Nithish-SA/Logic-Analyzer/README.md

# Logic-Analyzer
A 16 channel at 100Mhz Logic Analyzer which is supported by Cypress FX3 (USB 3.0 MCU).
