Nithish-SA/Logic-Analyzer/LA-V2.0.kicad_pcb

## KiCad design LA-V2.0.kicad_pcb (2025-07-25)

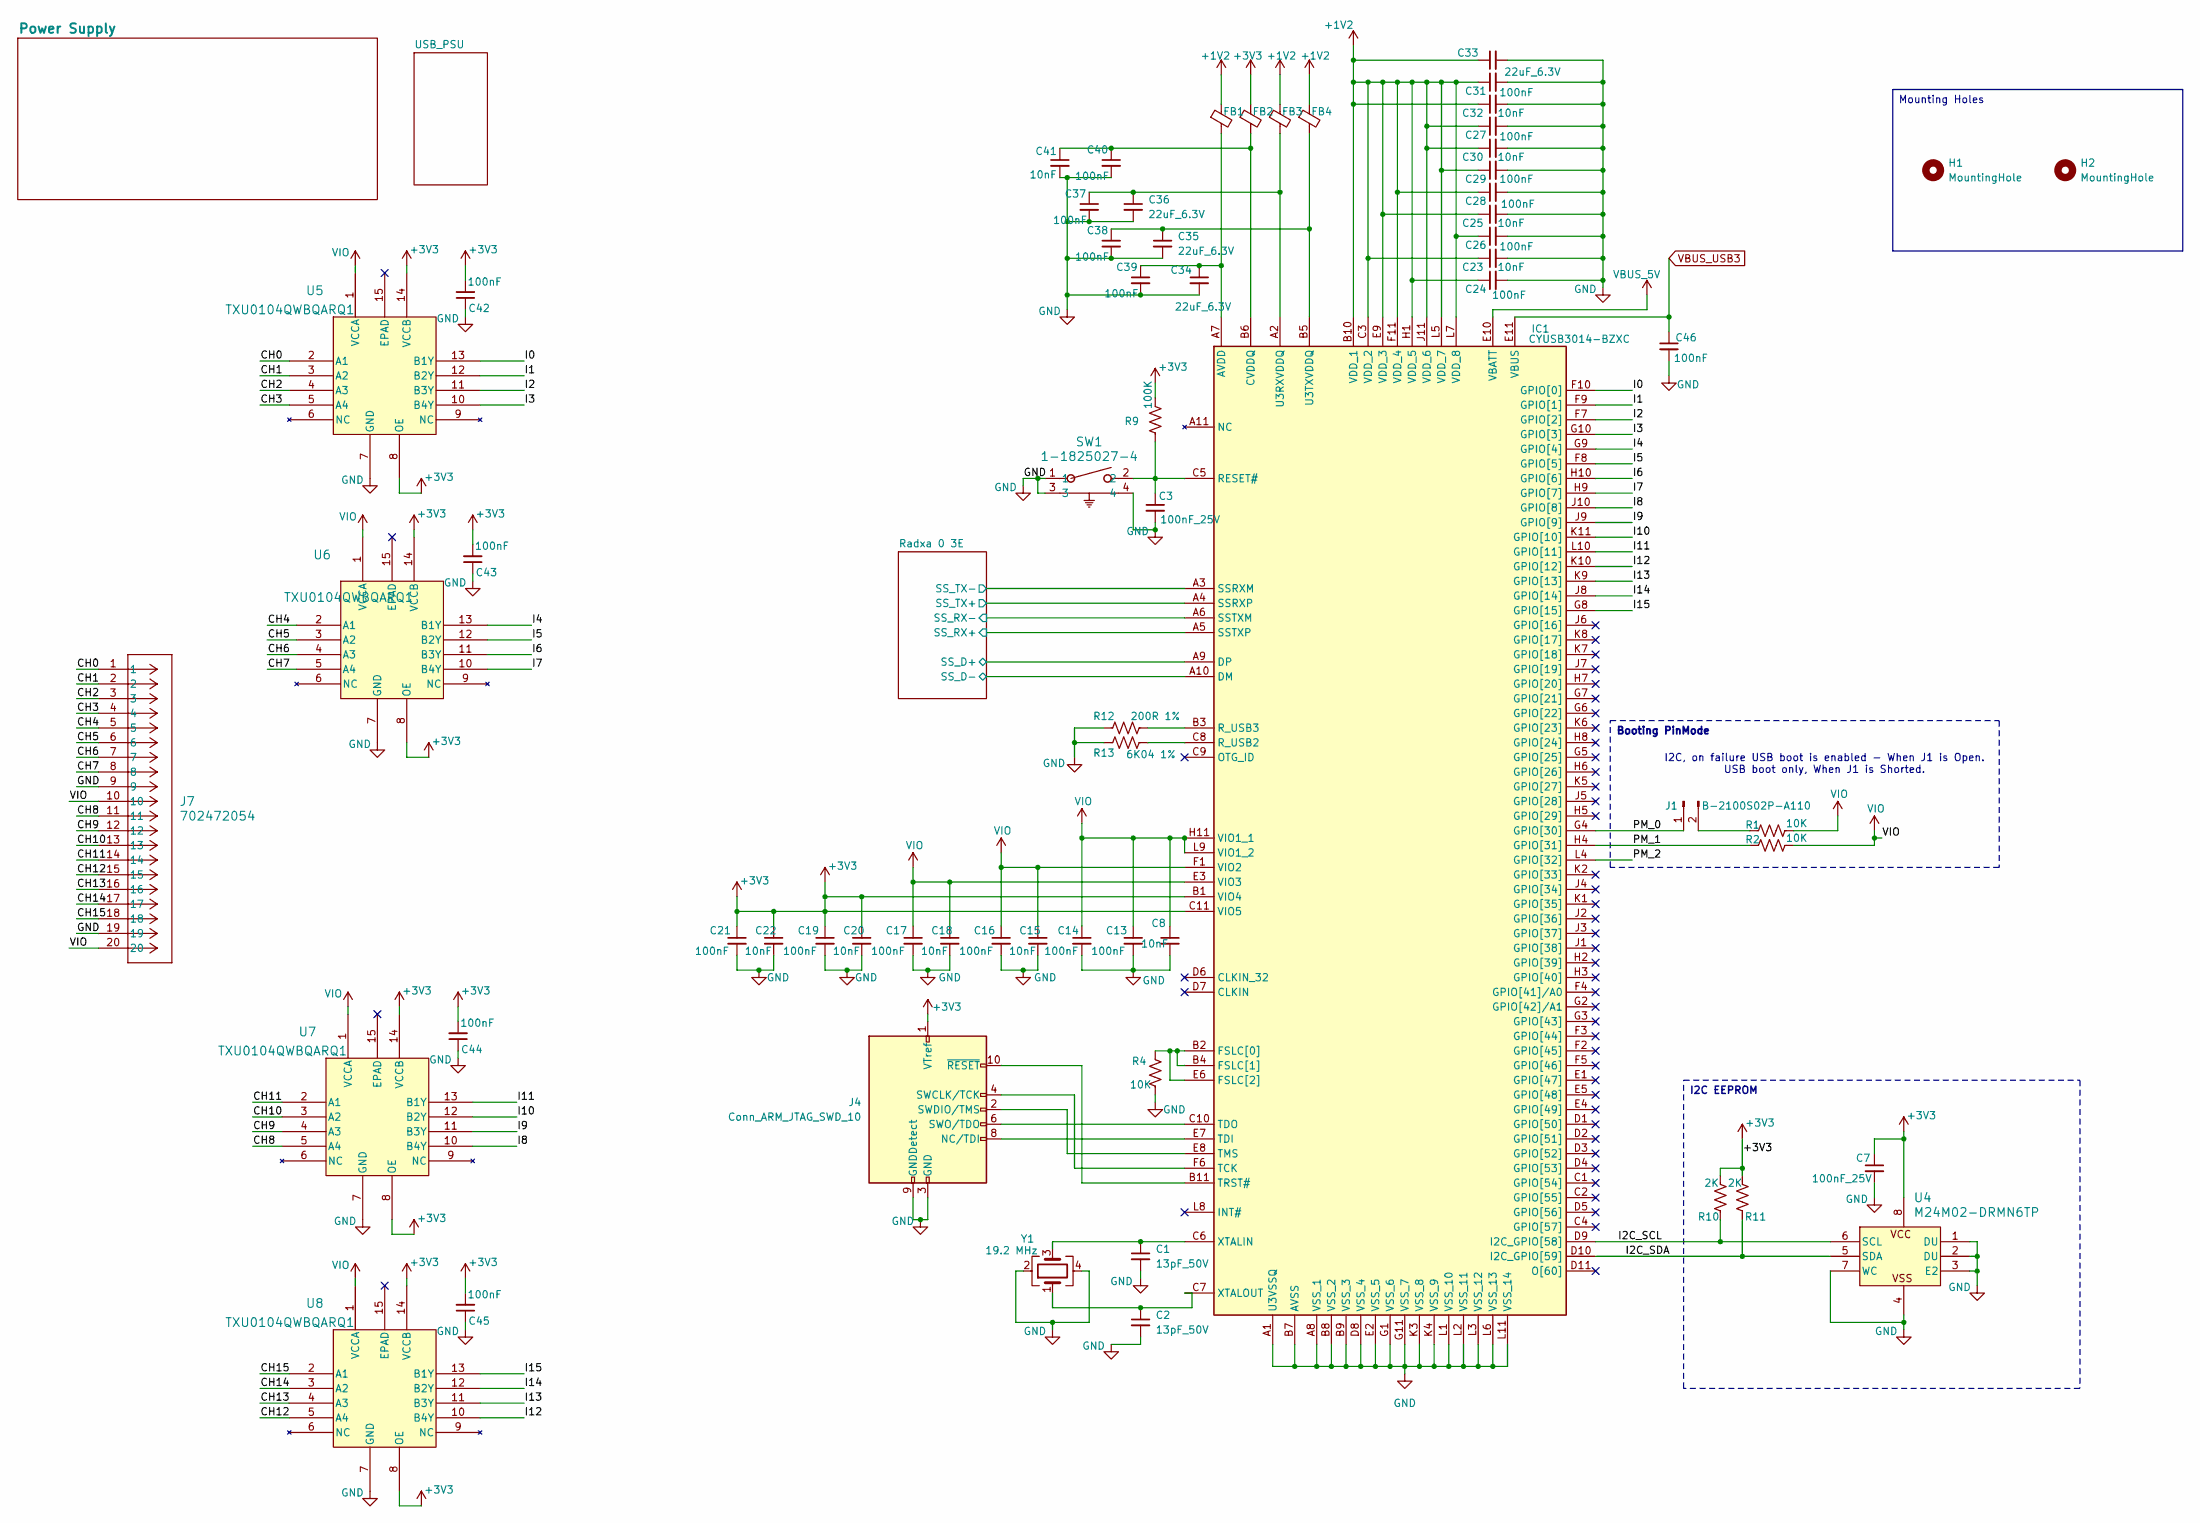
[picture p1: schematic LA-V2.0.kicad_sch]

Parts:
C1, C2: 13pF_50V; C_0402_1005Metric; LCSC Part# C161306
C3, C7: 100nF_25V; C_0402_1005Metric; LCSC Part# C155422
C8, C15, C18, C20, C22, C23, C25, C30, C32, C41: 10nF; C_0402_1005Metric; LCSC Part# C60133
C13, C14, C16, C17, C19, C21, C24, C26, C27, C28, C29, C31, C37, C38, C39, C40, C42, C43, C44, C45, C46: 100nF; C_0402_1005Metric; LCSC Part# C155422
C33: 22uF_6.3V; C_0805_2012Metric; LCSC Part# C5674
C34, C35, C36: 22uF_6.3V; C_0402_1005Metric; LCSC Part# C415703
FB1, FB2, FB3, FB4: FerriteBead_Small; L_0805_2012Metric; LCSC Part# C81034
H1, H2: MountingHole; MountingHole_2.7mm_M2.5_ISO14580_Pad_TopOnly
IC1: CYUSB3014-BZXC; Manufacturer_Part_Number CYUSB3014-BZXC; LCSC Part# C462526
J1: B-2100S02P-A110; PinHeader_1x02_P2.54mm_Vertical; LCSC Part# C124375
J4: Conn_ARM_JTAG_SWD_10; PinHeader_2x05_P2.54mm_Vertical; LCSC Part# C492422
J7: 702472054; CONN_7024720xx_MOL; LCSC Part# C17505050
R1, R2, R4: 10K; R_0402_1005Metric; LCSC Part# C60490
R9: 100K; R_0805_2012Metric; LCSC Part# C122537
R10, R11: 2K; R_0805_2012Metric; LCSC Part# C114572
R12: 200R 1%; R_0402_1005Metric; LCSC Part# C114764
R13: 6K04 1%; R_0805_2012Metric; LCSC Part# C3014413
SW1: 1-1825027-4; SW2_1825027-E_TEC; LCSC Part# C2928195
U4: M24M02-DRMN6TP; SO_RMN6TP_STM; LCSC Part# C115042
U5, U6, U7, U8: TXU0104QWBQARQ1; WQFN14_BQA_TEX; LCSC Part# C5217874
Y1: 19.2 MHz; Crystal_SMD_3225-4Pin_3.2x2.5mm; LCSC Part# C7294560

Connections:
+1V2: C23.1, C24.1, C25.1, C26.1, C27.1, C28.1, C29.1, C30.1, C31.1, C32.1, C33.1, FB1.1, FB3.1, FB4.1, IC1.B10 (VDD_1), IC1.C3 (VDD_2), IC1.E9 (VDD_3), IC1.F11 (VDD_4), IC1.H1 (VDD_5), IC1.J11 (VDD_6), IC1.L5 (VDD_7), IC1.L7 (VDD_8); also elsewhere on the board
+3V3: C7.1, C19.1, C20.1, C21.1, C22.1, C42.2, C43.2, C44.2, C45.2, FB2.1, IC1.B1 (VIO4), IC1.C11 (VIO5), J4.1 (VTref), R9.2, R10.2, R11.2, U4.8, U5.8 (OE), U5.14 (VCCB), U6.8 (OE), U6.14 (VCCB), U7.8 (OE), U7.14 (VCCB), U8.8 (OE), U8.14 (VCCB); also elsewhere on the board
/CH0: J7.1, U5.2 (A1)
/CH1: J7.2, U5.3 (A2)
/CH2: J7.3, U5.4 (A3)
/CH3: J7.4, U5.5 (A4)
/CH4: J7.5, U6.2 (A1)
/CH5: J7.6, U6.3 (A2)
/CH6: J7.7, U6.4 (A3)
/CH7: J7.8, U6.5 (A4)
/CH8: J7.11, U7.5 (A4)
/CH9: J7.12, U7.4 (A3)
/CH10: J7.13, U7.3 (A2)
/CH11: J7.14, U7.2 (A1)
/CH12: J7.15, U8.5 (A4)
/CH13: J7.16, U8.4 (A3)
/CH14: J7.17, U8.3 (A2)
/CH15: J7.18, U8.2 (A1)
/I0: IC1.F10 (GPIO[0]), U5.13 (B1Y)
/I1: IC1.F9 (GPIO[1]), U5.12 (B2Y)
/I2: IC1.F7 (GPIO[2]), U5.11 (B3Y)
/I2C_SCL: IC1.D9 (I2C_GPIO[58]), R10.1, U4.6 (SCL)
/I2C_SDA: IC1.D10 (I2C_GPIO[59]), R11.1, U4.5 (SDA)
/I3: IC1.G10 (GPIO[3]), U5.10 (B4Y)
/I4: IC1.G9 (GPIO[4]), U6.13 (B1Y)
/I5: IC1.F8 (GPIO[5]), U6.12 (B2Y)
/I6: IC1.H10 (GPIO[6]), U6.11 (B3Y)
/I7: IC1.H9 (GPIO[7]), U6.10 (B4Y)
/I8: IC1.J10 (GPIO[8]), U7.10 (B4Y)
/I9: IC1.J9 (GPIO[9]), U7.11 (B3Y)
/I10: IC1.K11 (GPIO[10]), U7.12 (B2Y)
/I11: IC1.L10 (GPIO[11]), U7.13 (B1Y)
/I12: IC1.K10 (GPIO[12]), U8.10 (B4Y)
/I13: IC1.K9 (GPIO[13]), U8.11 (B3Y)
/I14: IC1.J8 (GPIO[14]), U8.12 (B2Y)
/I15: IC1.G8 (GPIO[15]), U8.13 (B1Y)
/PM_0: IC1.G4 (GPIO[30]), J1.1
/PM_1: IC1.H4 (GPIO[31]), R2.1
/PM_2: IC1.L4 (GPIO[32])
/Radxa 0 3E/SS_D+: IC1.A9 (DP); also elsewhere on the board
/Radxa 0 3E/SS_D-: IC1.A10 (DM); also elsewhere on the board
/Radxa 0 3E/SS_RX+: IC1.A5 (SSTXP); also elsewhere on the board
/Radxa 0 3E/SS_RX-: IC1.A6 (SSTXM); also elsewhere on the board
/Radxa 0 3E/SS_TX+: IC1.A4 (SSRXP); also elsewhere on the board
/Radxa 0 3E/SS_TX-: IC1.A3 (SSRXM); also elsewhere on the board
GND: C1.2, C2.2, C3.2, C7.2, C8.2, C13.2, C14.2, C15.2, C16.2, C17.2, C18.2, C19.2, C20.2, C21.2, C22.2, C23.2, C24.2, C25.2, C26.2, C27.2, C28.2, C29.2, C30.2, C31.2, C32.2, C33.2, C34.2, C35.2, C36.2, C37.2, C38.2, C39.2, C40.2, C41.2, C42.1, C43.1, C44.1, C45.1, C46.2, IC1.A1 (U3VSSQ), IC1.A8 (VSS_1), IC1.B7 (AVSS), IC1.B8 (VSS_2), IC1.B9 (VSS_3), IC1.D8 (VSS_4), IC1.E2 (VSS_5), IC1.G1 (VSS_6), IC1.G11 (VSS_7), IC1.K3 (VSS_8), IC1.K4 (VSS_9), IC1.L1 (VSS_10), IC1.L2 (VSS_11), IC1.L3 (VSS_12), IC1.L6 (VSS_13), IC1.L11 (VSS_14), J4.3 (GND), J4.5 (GND), J4.9 (GNDDetect), J7.9, J7.19, R4.1, R12.2, R13.2, SW1.1, SW1.3, SW1.4, U4.1 (DU), U4.2 (DU), U4.3 (E2), U4.4, U4.7 (WC), U5.7 (GND), U6.7 (GND), U7.7 (GND), U8.7 (GND), Y1.2, Y1.4; also elsewhere on the board
unnamed: C34.1, C39.1, FB1.2, IC1.A7 (AVDD)
unnamed: C40.1, C41.1, FB2.2, IC1.B6 (CVDDQ)
unnamed: IC1.B2 (FSLC[0]), IC1.B4 (FSLC[1]), IC1.E6 (FSLC[2]), R4.2
unnamed: C3.1, IC1.C5 (RESET#), R9.1, SW1.2
unnamed: IC1.C8 (R_USB2), R13.1
unnamed: IC1.B3 (R_USB3), R12.1
unnamed: IC1.F6 (TCK), J4.4 (SWCLK/TCK)
unnamed: IC1.E7 (TDI), J4.8 (NC/TDI)
unnamed: IC1.C10 (TDO), J4.6 (SWO/TDO)
unnamed: IC1.E8 (TMS), J4.2 (SWDIO/TMS)
unnamed: IC1.B11 (TRST#), J4.10 (~RESET)
unnamed: C36.1, C37.1, FB3.2, IC1.A2 (U3RXVDDQ)
unnamed: C35.1, C38.1, FB4.2, IC1.B5 (U3TXVDDQ)
unnamed: C1.1, IC1.C6 (XTALIN), Y1.3
unnamed: C2.1, IC1.C7 (XTALOUT), Y1.1
unnamed: J1.2, R1.1
VBUS_5V: IC1.E10 (VBATT); also elsewhere on the board
VBUS_USB3: C46.1, IC1.E11 (VBUS); also elsewhere on the board
VIO: C8.1, C13.1, C14.1, C15.1, C16.1, C17.1, C18.1, IC1.E3 (VIO3), IC1.F1 (VIO2), IC1.H11 (VIO1_1), IC1.L9 (VIO1_2), J7.10, J7.20, R1.2, R2.2, U5.1 (VCCA), U6.1 (VCCA), U7.1 (VCCA), U8.1 (VCCA); also elsewhere on the board

Notes on the sheet:
I2C, on failure USB boot is enabled - When J1 is Open. USB boot only, When J1 is Shorted.
Booting PinMode
I2C EEPROM
Mounting Holes

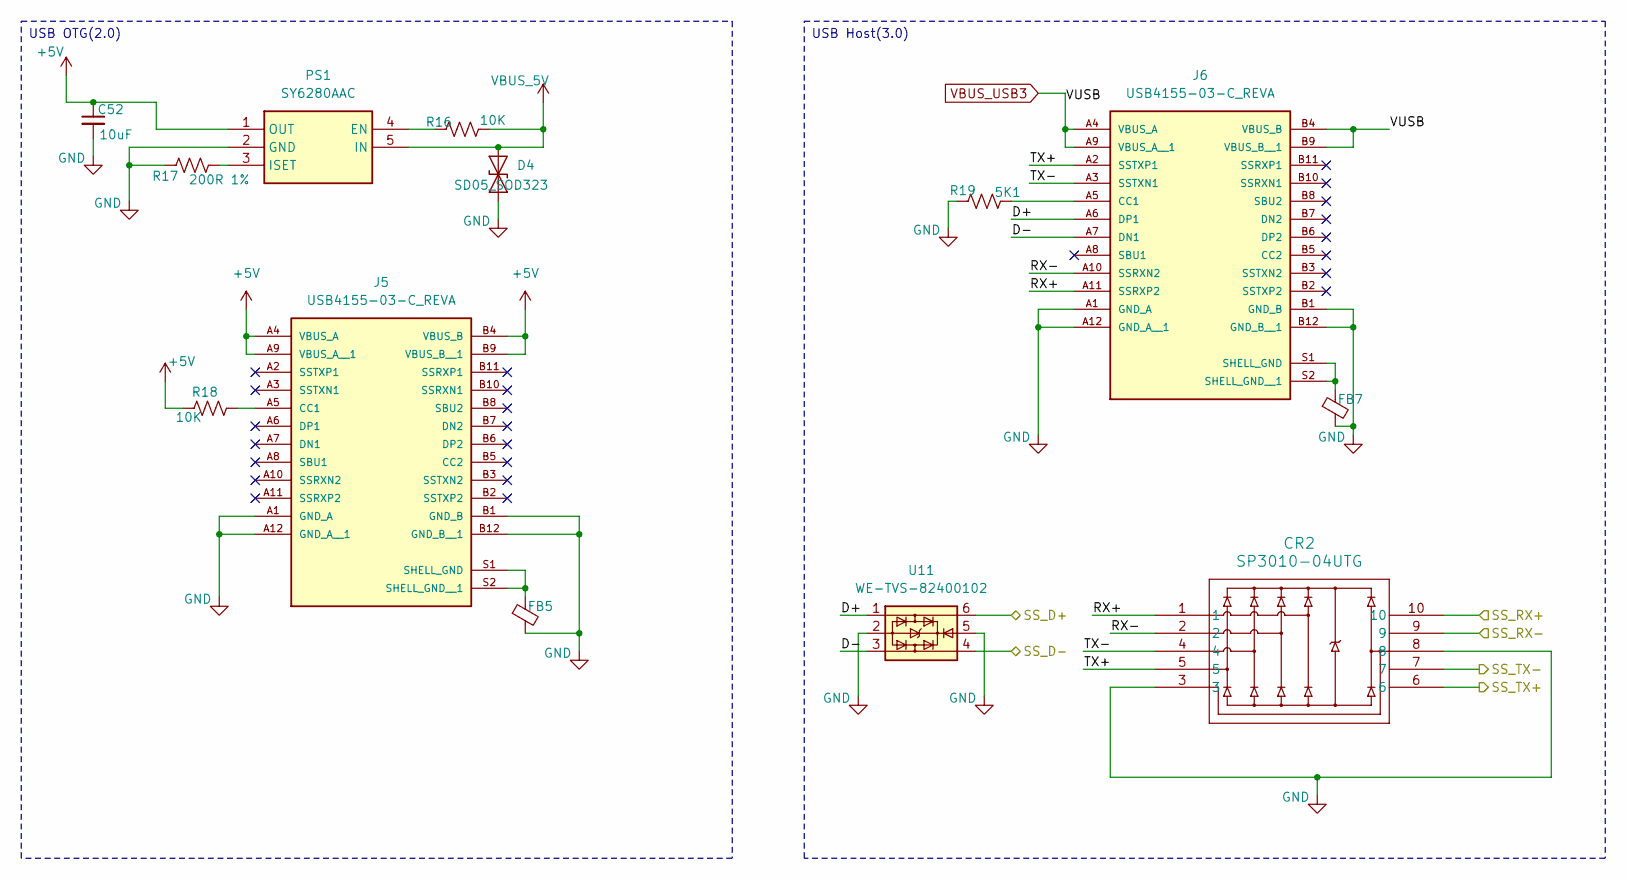
[picture p2: schematic Radxa.kicad_sch]

Parts:
C52: 10uF; C_0402_1005Metric; LCSC Part# C32635
CR2: SP3010-04UTG; UDFEN-10_MO229_LTF-L; LCSC Part# C126837
D4: SD05_SOD323; D_SOD-323
FB5, FB7: FerriteBead_Small; L_0805_2012Metric; LCSC Part# C81034
J5, J6: USB4155-03-C_REVA; USB Plug-GCT_USB4155-03-C_REVA; PARTREV A
PS1: SY6280AAC; SOT95P285X140-5N; Manufacturer_Part_Number SY6280AAC
R16, R18: 10K; R_0402_1005Metric; LCSC Part# C60490
R17: 200R 1%; R_0402_1005Metric; LCSC Part# C114764
R19: 5K1; R_0402_1005Metric; LCSC Part# C351692
U11: WE-TVS-82400102; SOT-23-6; LCSC Part# C22435120

Connections:
+5V: C52.1, J5.A4 (VBUS_A), J5.A9 (VBUS_A__1), J5.B4 (VBUS_B), J5.B9 (VBUS_B__1), PS1.1 (OUT), R18.1
/Radxa 0 3E/D+: J6.A6 (DP1), U11.1
/Radxa 0 3E/D-: J6.A7 (DN1), U11.3
/Radxa 0 3E/RX+: CR2.1, J6.A11 (SSRXP2)
/Radxa 0 3E/RX-: CR2.2, J6.A10 (SSRXN2)
/Radxa 0 3E/SS_D+: U11.6; also elsewhere on the board
/Radxa 0 3E/SS_D-: U11.4; also elsewhere on the board
/Radxa 0 3E/SS_RX+: CR2.10; also elsewhere on the board
/Radxa 0 3E/SS_RX-: CR2.9; also elsewhere on the board
/Radxa 0 3E/SS_TX+: CR2.6; also elsewhere on the board
/Radxa 0 3E/SS_TX-: CR2.7; also elsewhere on the board
/Radxa 0 3E/TX+: CR2.5, J6.A2 (SSTXP1)
/Radxa 0 3E/TX-: CR2.4, J6.A3 (SSTXN1)
GND: C52.2, CR2.3, CR2.8, D4.1 (A1), FB5.2, FB7.2, J5.A1 (GND_A), J5.A12 (GND_A__1), J5.B1 (GND_B), J5.B12 (GND_B__1), J6.A1 (GND_A), J6.A12 (GND_A__1), J6.B1 (GND_B), J6.B12 (GND_B__1), PS1.2 (GND), R17.2, R19.2, U11.2, U11.5; also elsewhere on the board
unnamed: J5.A5 (CC1), R18.2
unnamed: FB5.1, J5.S1 (SHELL_GND), J5.S2 (SHELL_GND__1)
unnamed: J6.A5 (CC1), R19.1
unnamed: FB7.1, J6.S1 (SHELL_GND), J6.S2 (SHELL_GND__1)
unnamed: PS1.4 (EN), R16.1
unnamed: PS1.3 (ISET), R17.1
VBUS_5V: D4.2 (A2), PS1.5 (IN), R16.2; also elsewhere on the board
VBUS_USB3: J6.A4 (VBUS_A), J6.A9 (VBUS_A__1), J6.B4 (VBUS_B), J6.B9 (VBUS_B__1); also elsewhere on the board

Notes on the sheet:
USB OTG(2.0)
USB Host(3.0)

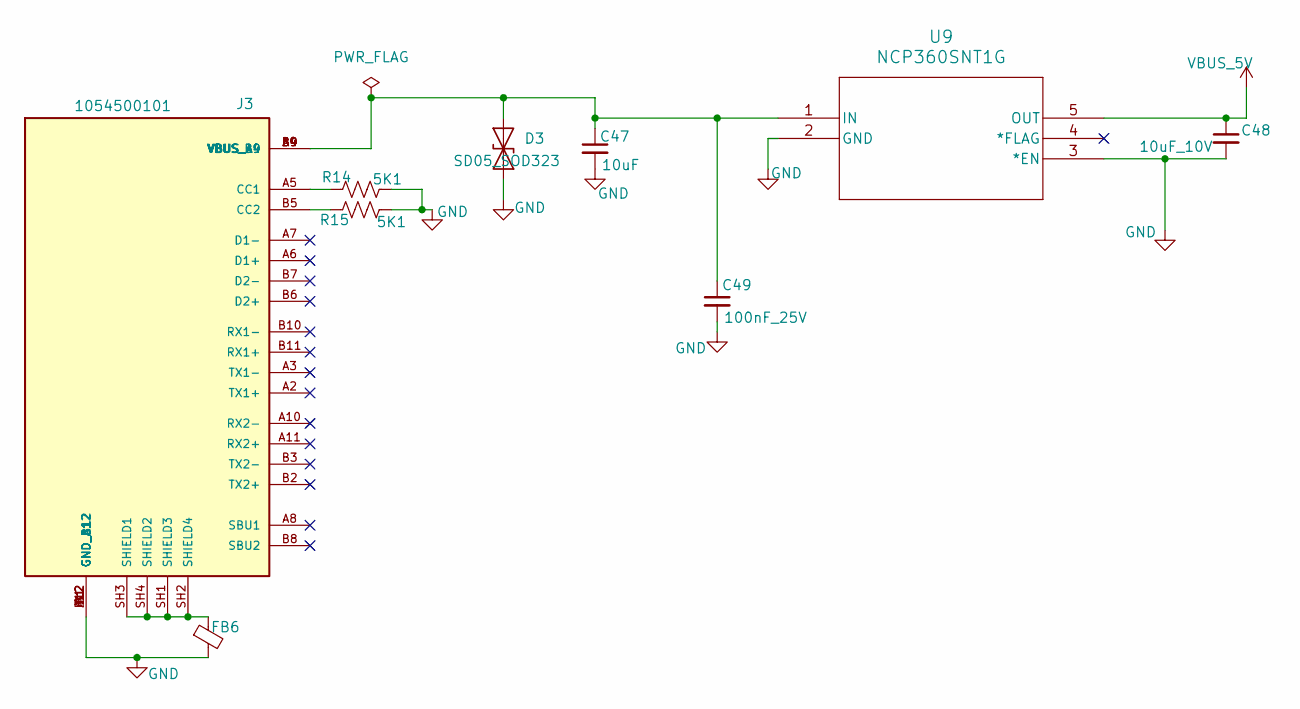
[picture p3: schematic USB_PSU.kicad_sch]

Parts:
C47: 10uF; C_0402_1005Metric; LCSC Part# C32635
C48: 10uF_10V; C_0402_1005Metric; LCSC Part# C32635
C49: 100nF_25V; C_0402_1005Metric; LCSC Part# C155422
D3: SD05_SOD323; D_SOD-323
FB6: FerriteBead_Small; L_0805_2012Metric; LCSC Part# C81034
J3: 1054500101; MOLEX_1054500101; PARTREV A7; LCSC Part# C134092
R14, R15: 5K1; R_0402_1005Metric; LCSC Part# C351692
U9: NCP360SNT1G; TSOP5_3X1P5_ONS; LCSC Part# C603707

Connections:
GND: C47.2, C48.2, C49.2, D3.1 (A1), FB6.2, J3.A1 (GND_A1), J3.A12 (GND_A12), J3.B1 (GND_B1), J3.B12 (GND_B12), R14.1, R15.1, U9.2 (GND), U9.3 (*EN); also elsewhere on the board
unnamed: C47.1, C49.1, D3.2 (A2), J3.A4 (VBUS_A4), J3.A9 (VBUS_A9), J3.B4 (VBUS_B4), J3.B9 (VBUS_B9), U9.1 (IN)
unnamed: J3.A5 (CC1), R14.2
unnamed: J3.B5 (CC2), R15.2
unnamed: FB6.1, J3.SH1 (SHIELD3), J3.SH2 (SHIELD4), J3.SH3 (SHIELD1), J3.SH4 (SHIELD2)
VBUS_5V: C48.1, U9.5 (OUT); also elsewhere on the board

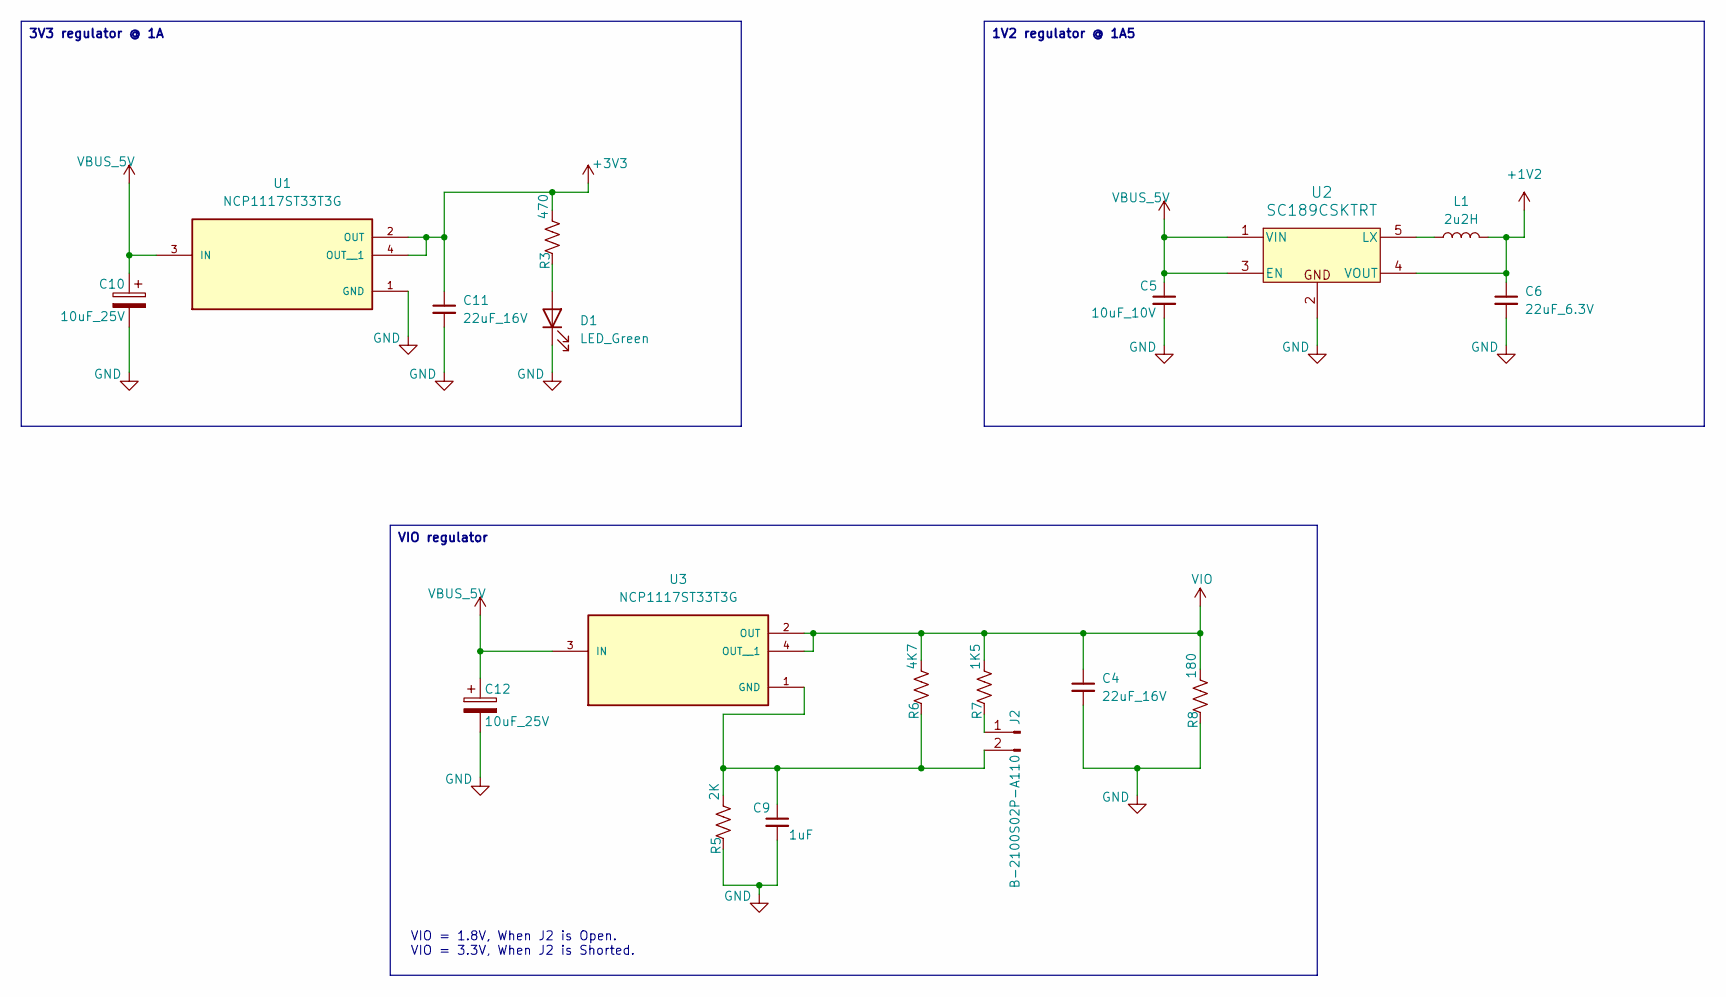
[picture p4: schematic Power Supply.kicad_sch]

Parts:
C4, C11: 22uF_16V; C_0805_2012Metric; LCSC Part# C296720
C5: 10uF_10V; C_0805_2012Metric; LCSC Part# C32635
C6: 22uF_6.3V; C_0805_2012Metric; LCSC Part# C5674
C9: 1uF; C_0603_1608Metric; Mfg PN CL10A105KP8NNNC; LCSC Part# C26413
C10, C12: 10uF_25V; CP_EIA-3528-12_Kemet-T; LCSC Part# C382102
D1: LED_Green; LED_0805_2012Metric; LCSC Part# C98221
J2: B-2100S02P-A110; PinHeader_1x02_P2.54mm_Vertical; LCSC Part# C124375
L1: 2u2H; L_0805_2012Metric; LCSC Part# C711165
R3: 470; R_0603_1608Metric; LCSC Part# C881392
R5: 2K; R_0805_2012Metric; LCSC Part# C114572
R6: 4K7; R_0805_2012Metric; LCSC Part# C60816
R7: 1K5; R_0805_2012Metric; LCSC Part# C865270
R8: 180; R_0805_2012Metric; LCSC Part# C137585
U1, U3: NCP1117ST33T3G; SOT230P700X180-4N
U2: SC189CSKTRT; SOT_CSKTRT_SEM; LCSC Part# C783594

Connections:
+1V2: C6.1, L1.2, U2.4 (VOUT); also elsewhere on the board
+3V3: C11.1, R3.2, U1.2 (OUT), U1.4 (OUT__1); also elsewhere on the board
GND: C4.2, C5.2, C6.2, C9.2, C10.2, C11.2, C12.2, D1.1 (K), R5.1, R8.1, U1.1 (GND), U2.2; also elsewhere on the board
unnamed: D1.2 (A), R3.1
unnamed: J2.1, R7.1
unnamed: C9.1, J2.2, R5.2, R6.1, U3.1 (GND)
unnamed: L1.1, U2.5 (LX)
VBUS_5V: C5.1, C10.1, C12.1, U1.3 (IN), U2.1 (VIN), U2.3 (EN), U3.3 (IN); also elsewhere on the board
VIO: C4.1, R6.2, R7.2, R8.2, U3.2 (OUT), U3.4 (OUT__1); also elsewhere on the board

Notes on the sheet:
VIO = 1.8V, When J2 is Open. VIO = 3.3V, When J2 is Shorted.
3V3 regulator @ 1A
VIO regulator
1V2 regulator @ 1A5

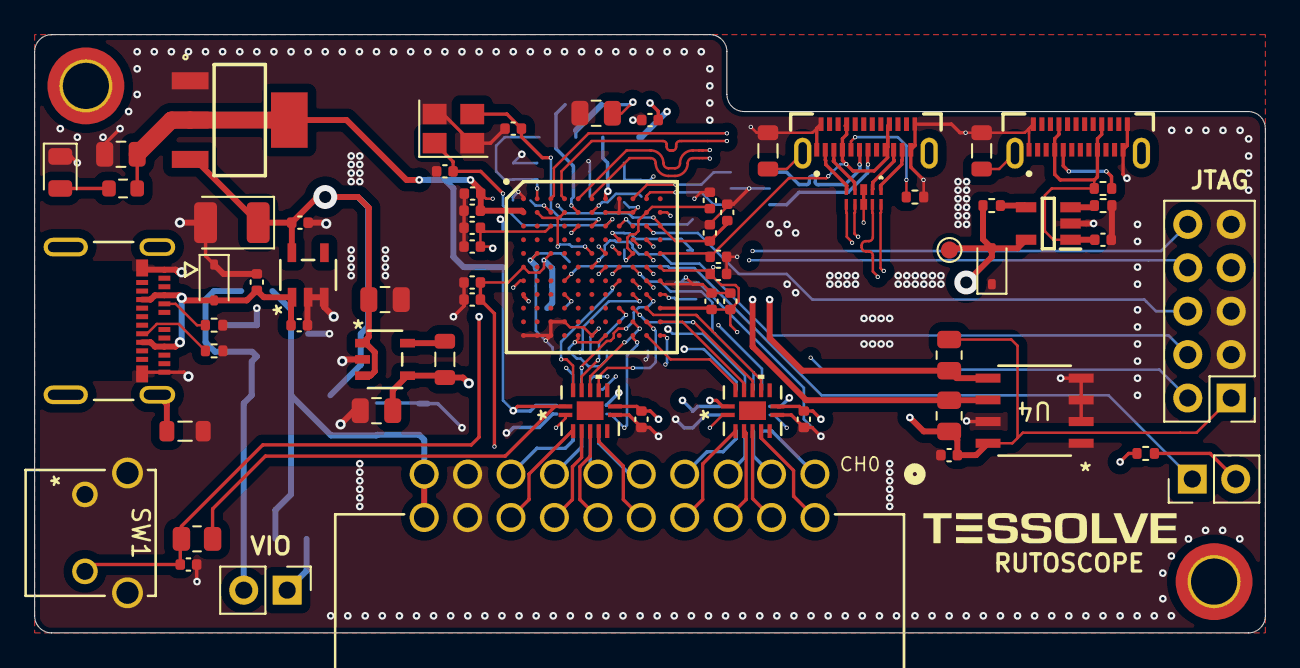
[picture p5: board LA-V2.0.kicad_pcb from above]

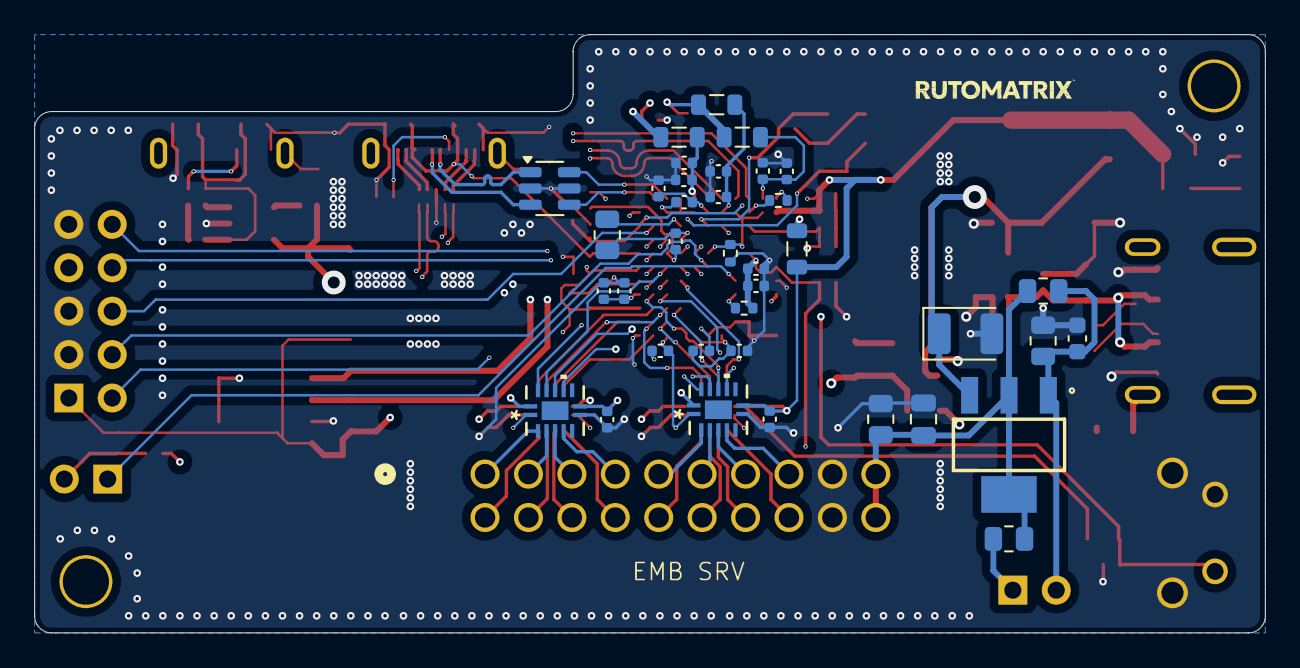
[picture p6: board LA-V2.0.kicad_pcb from below]

Board: 4 copper layers, 72.0 x 35.0 mm, 105 parts (37 on the bottom side), 85 nets.

Other parts of the board:
TP1: TestPoint_Pad_D1.0mm

Their connections:
VBUS_5V: TP1.1; also elsewhere on the board
